arvjus/exp-meter/calibration_fb.csv

filter | exp_h | exp_l
0 | 2.3898 | 50.0
1 | 2.3898 | 31.0
2 | 2.3898 | 19.7
3 | 2.7084 | 14.8
4 | 4.7796 | 17.5
