arvjus/exp-meter/calibration_rc5.csv

filter | exp_h | exp_l
0 | 2.3101 | 44.0
1 | 2.3898 | 29.0
2 | 2.7084 | 22.0
3 | 2.8678 | 16.0
4 | 5.5762 | 22.0
