arvjus/exp-meter/(commit log)

2026-07-17 initial checkin
    [calibration_fb.csv, calibration_rc5.csv]
2026-07-17 add samples
2026-07-22 new calibration data for FB
    [calibration_fb.csv]
2026-07-22 Revise minimum EV threshold for calibration
    Updated the minimum EV measurement threshold from 0.8 to 0.5 to enhance calibration accuracy.
2026-07-29 better user interface with rotary encoder
